mark-aster1/BuddyBot/Media/Insta360 Module.jpeg

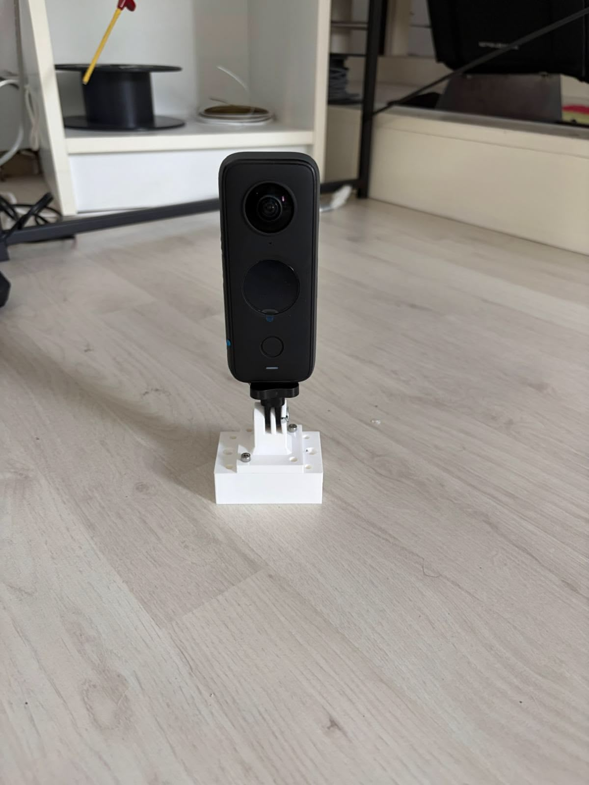
Media/Insta360 Module.jpeg
