mark-aster1/BuddyBot/Media/Basket Module.jpeg

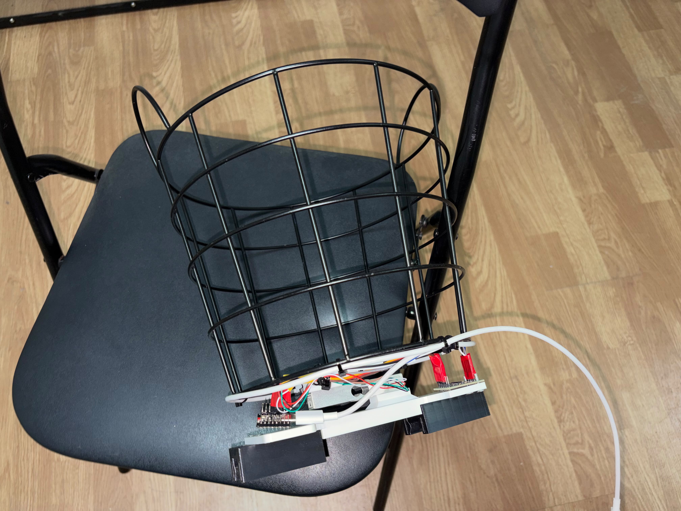
Media/Basket Module.jpeg
