mark-aster1/BuddyBot/Media/BLE Triangulation Visualization.png

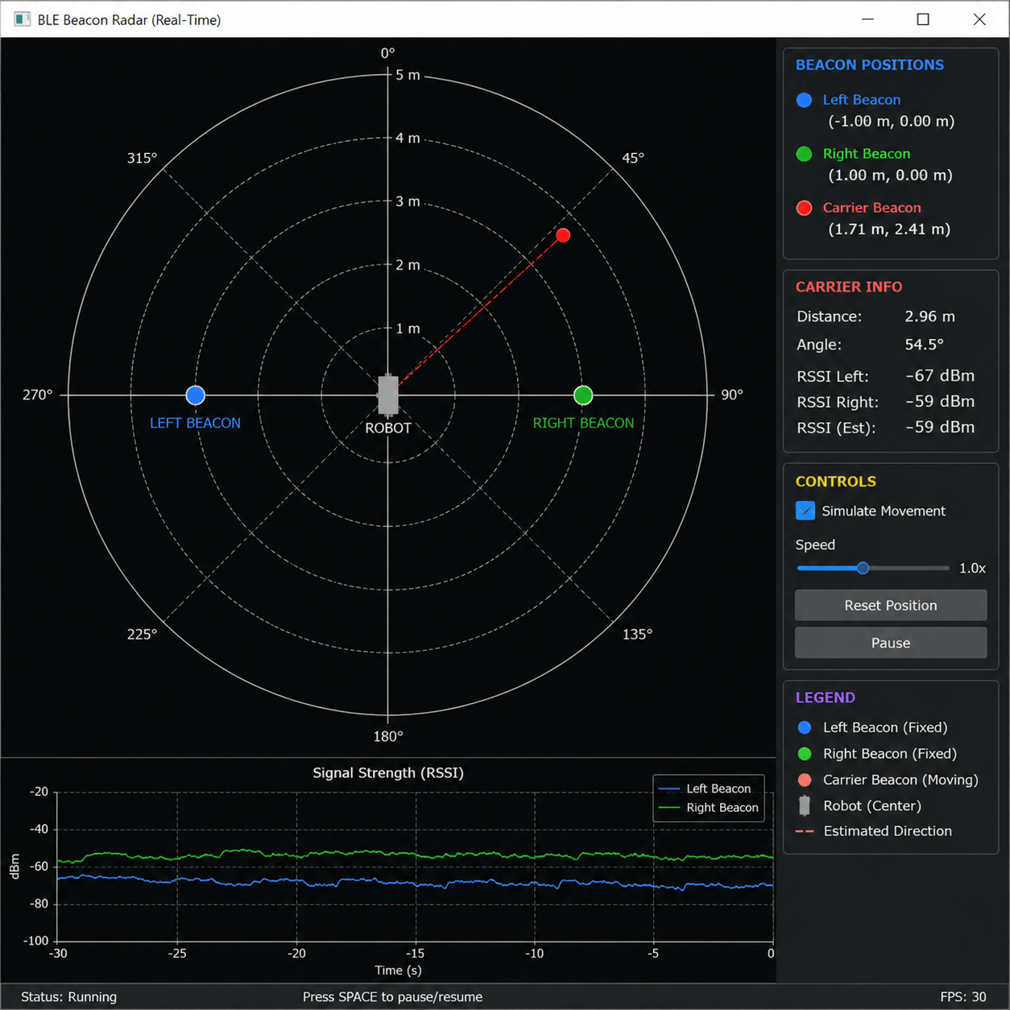
Media/BLE Triangulation Visualization.png
