mark-aster1/BuddyBot/Media/Cables!.jpeg

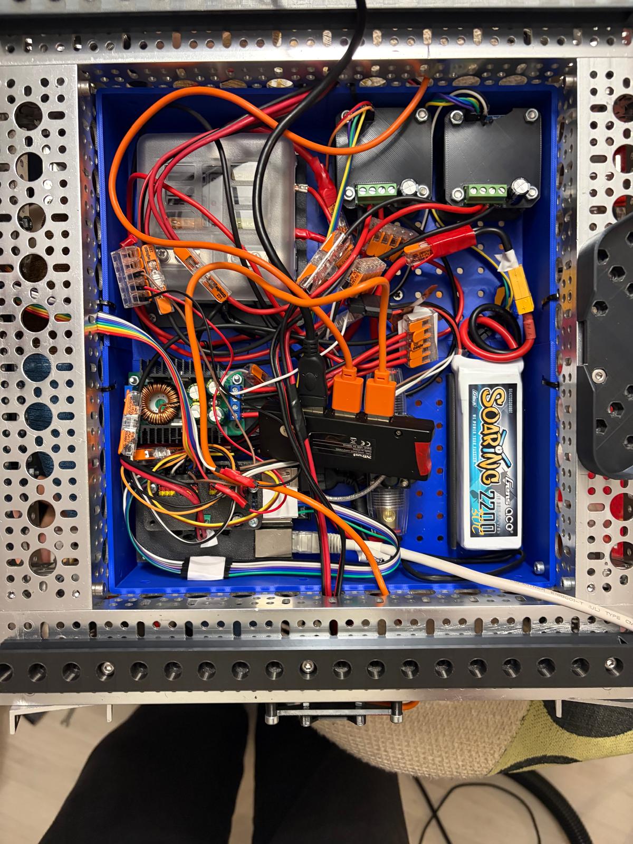
Media/Cables!.jpeg
