mark-aster1/BuddyBot/Media/CAD Robot.jpeg

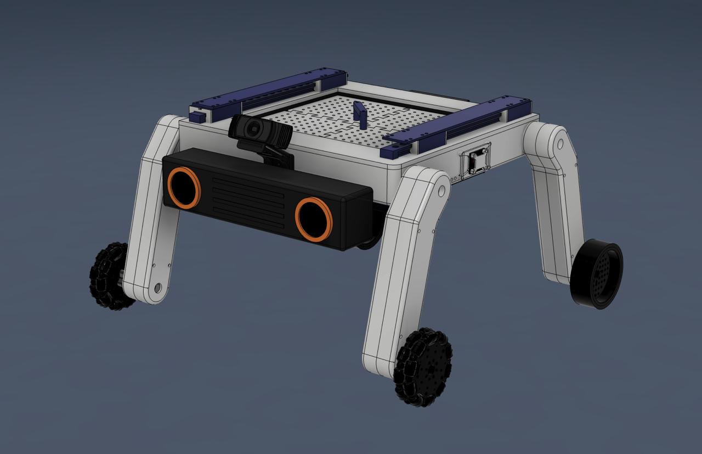
Media/CAD Robot.jpeg
