mark-aster1/BuddyBot/Media/IMG_0089.PNG

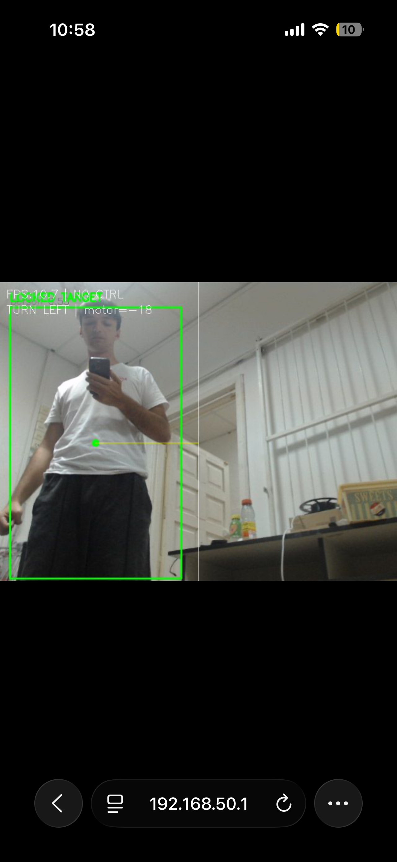
Media/IMG_0089.PNG
