mark-aster1/BuddyBot/Media/IMG_0090.jpg

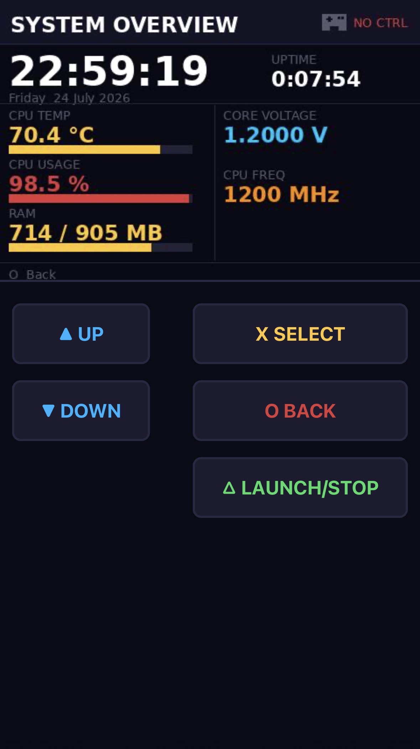
Media/IMG_0090.jpg
