mark-aster1/BuddyBot/Media/Robot Arm Module.jpeg

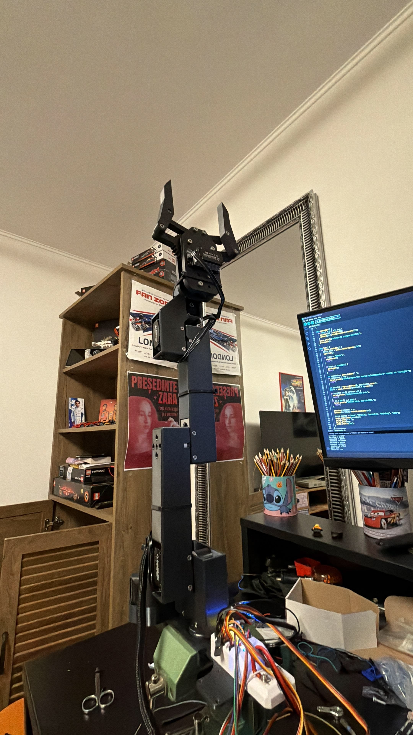
Media/Robot Arm Module.jpeg
