mark-aster1/BuddyBot/Media/Undervoltage.png

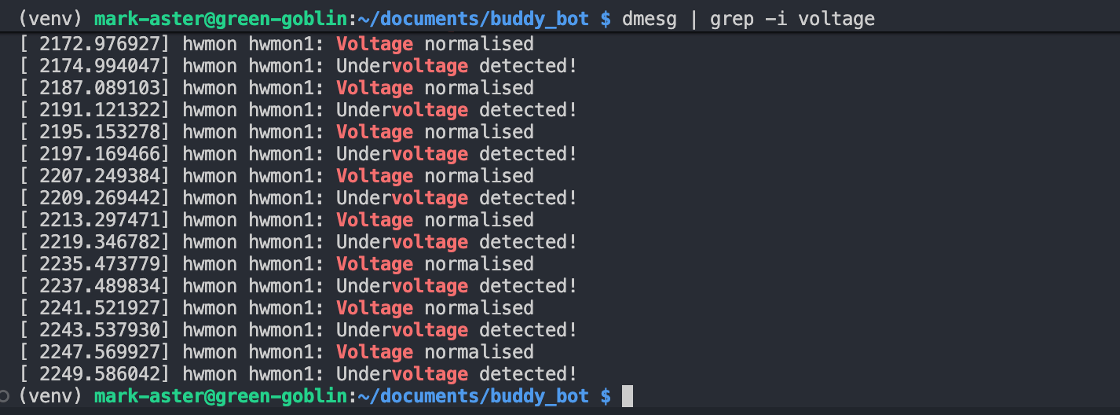
Media/Undervoltage.png
